th-koeln-optec-messsysteme/Lithium_Primary_Battery_Tester/doc/circuit_diagram/SchaltplanV1.png

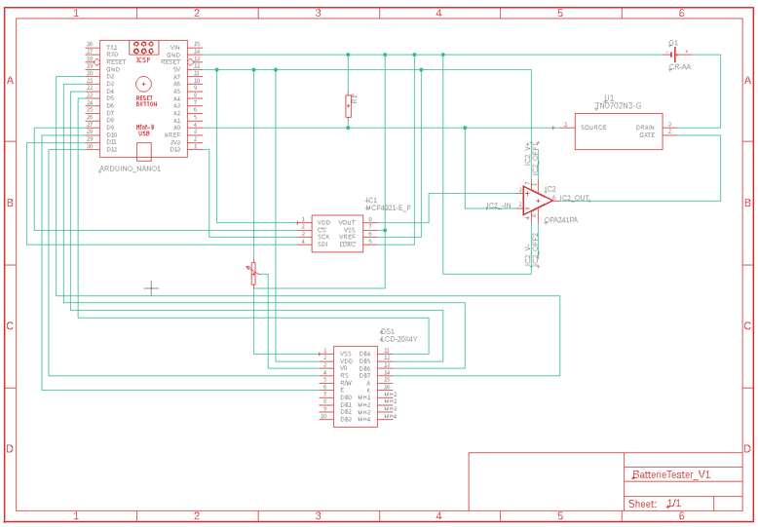
doc/circuit_diagram/SchaltplanV1.png
