th-koeln-optec-messsysteme/Lithium_Primary_Battery_Tester/doc/measurement_results/impulse/350mA_impuls_5s_25_200ms_pro_div.png

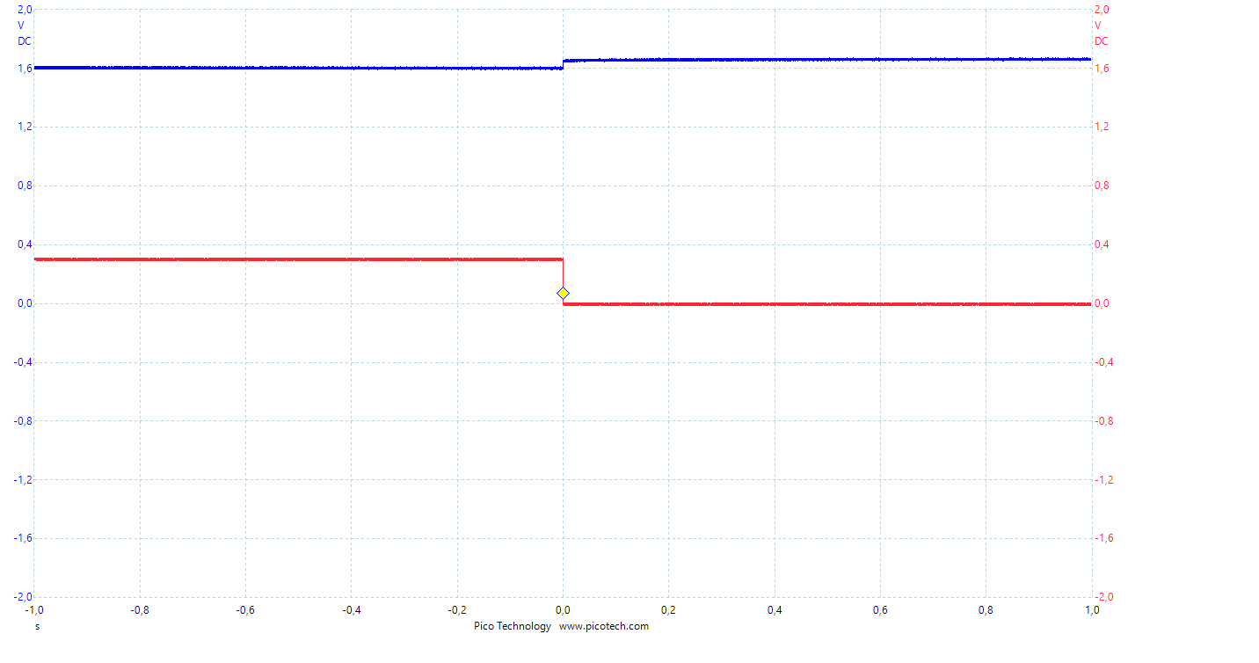
doc/measurement_results/impulse/350mA_impuls_5s_25_200ms_pro_div.png
