th-koeln-optec-messsysteme/Lithium_Primary_Battery_Tester/(commit log)

2020-07-12 Add files via upload
    Dieser Arduino Scetch dient dazu, die Spannung bei einer Last von 100mA aufzunehmen. Dazu wird zuerst eine Messung durchgeführt. Anschließend wird die Batterie mit 350mA entladen, bis sie 5% der Kapazität verloren hat. Dieser Vorgang wiederholt sich in 5% schritten so lange, bis die Batterie leer ist. Während des 100mA Impulses wird jede Millisekunde eine Analogmessung durchgeführt, bis 500 Messungen vorhanden sind. Diese werden dann aufaddiert und in einem Array abgespeichert. Die Messungen wurden nicht in eine Spannung umgerechnet, sondern sollen hinterher mit den Werten der zu testenden Batterie verglichen werden.
2020-07-22 Links der Bibs eingefügt
